zelogik/RicinoNext/Hardware/Emitter/irda_robi/IMG_20210915_181401.jpg

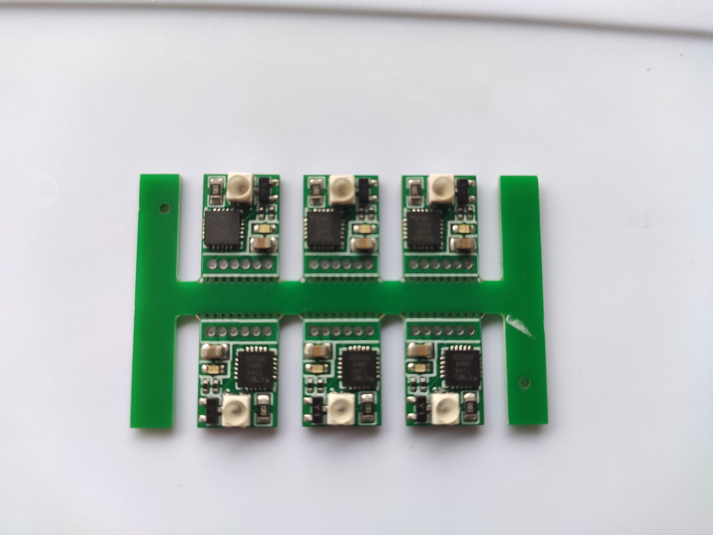
Hardware/Emitter/irda_robi/IMG_20210915_181401.jpg
