zelogik/RicinoNext/Hardware/Receiver/irda_robi_extension/IMG_20210915_181441.jpg

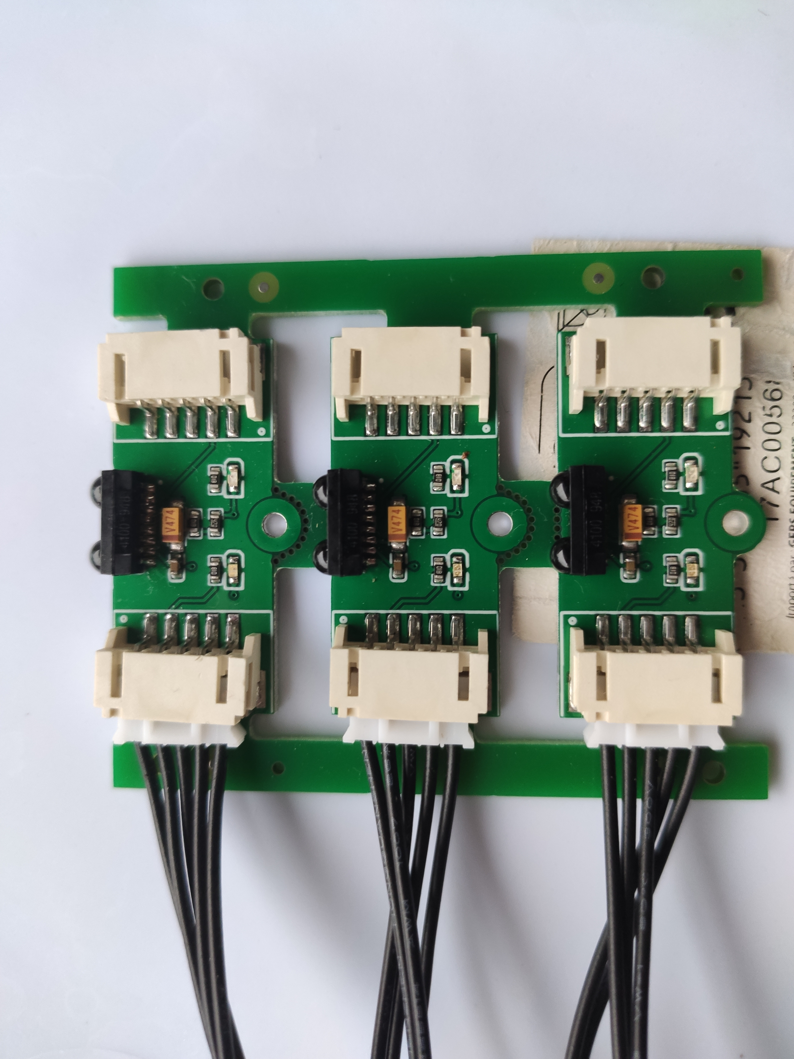
Hardware/Receiver/irda_robi_extension/IMG_20210915_181441.jpg
