zelogik/RicinoNext/Hardware/Controller/README.md

Could be an:

ESP32, ESP8266

or 

SAMD21 + ESP01/WS5x00

current dev is done on TTGO-display (ESP32), and a Seeduino Xaio (SAMD21) (without network stack).
