zelogik/RicinoNext/Software/Controller/README.md

# RicinoNext

ESP32 ie: ttGo t-display
IR led receiver
.. that all for the moment...
