zelogik/RicinoNext/Hardware/Emitter/irda_robi/PCB_x6.png

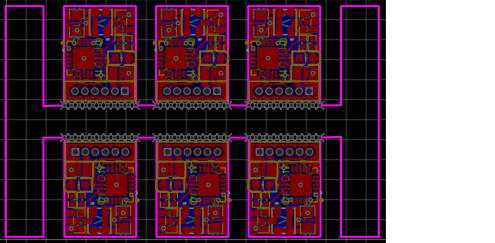
Hardware/Emitter/irda_robi/PCB_x6.png
