zelogik/RicinoNext/Hardware/Receiver/irda_robi/IMG_20210915_181500.jpg

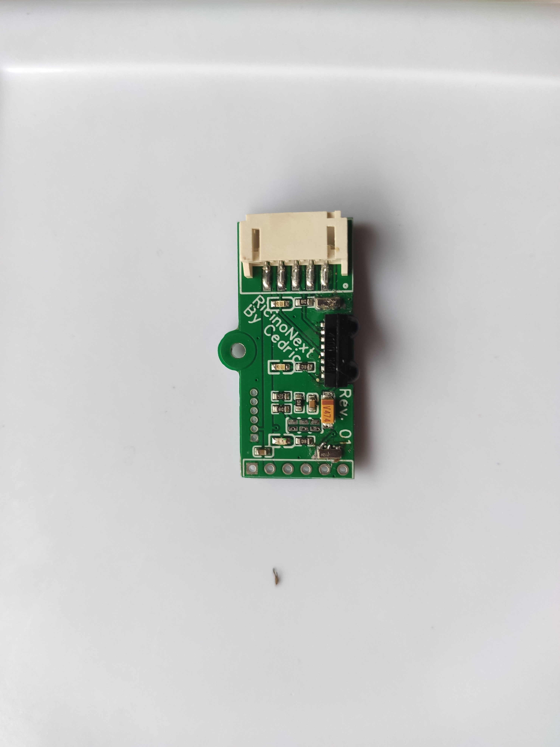
Hardware/Receiver/irda_robi/IMG_20210915_181500.jpg
