zelogik/RicinoNext/Software/Receiver/irda_robi/Decoding Scheme IRDA.png

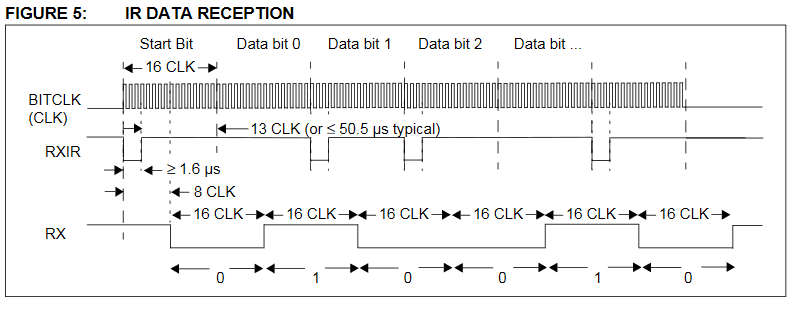
Software/Receiver/irda_robi/Decoding Scheme IRDA.png
