zelogik/RicinoNext/Hardware/Receiver/irda_robi/PCB files/BOM_PCB_IRDA_2021-09-16.csv

ID | Name | Designator | Footprint | Quantity | Manufacturer Part | Manufacturer | Supplier | Supplier Part | Price
1 | 1K | R1,R2,R3,R5,R6 | R0603 | 5 | 0603WAF1001T5E | UniOhm | LCSC | C21190 | 0.001
2 | 47 | R4 | R0603 | 1 | 0603WAF470JT5E | UniOhm | LCSC | C23182 | 0.001
3 | KT-0603R | LED1 | LED0603-R-RD | 1 | KT-0603R | KENTO | LCSC | C2286
4 | 100nF | C3,C1 | C0603 | 2 | CC0603KRX7R9BB104 | YAGEO | LCSC | C14663 | 0.003
5 | CSTNE16M0V53C000R0 | X1,X2 | OSC-SMD_3P-L3.2-W1.3-P1.20-L | 2 | CSTNE16M0V53C000R0 | muRata(村田) | LCSC | C882606 | 0.346
6 | 470nF | C2 | CAP-SMD_L3.2-W1.6-R-RD | 1 | TC211A474K035Y | Sunlord | LCSC | C128329 | 0.107
7 | SOLDERJUMPERNO | SJ4,SJ5,SJ3 | SJ_2S-NO | 3
8 | TFDU4100-TR3 | U1 | TFDU4100H | 1
9 | 19-217/GHC-YR1S2/3T | LED2 | LED0603-R-RD | 1 | 19-217/GHC-YR1S2/3T | EVERLIGHT | LCSC | C72043 | 0.025
10 | HEADER_6 | J1 | HDR-M-2.54_1X6 | 1
11 | A2001WR-S-5P_C225236 | CN2 | CONN-SMD_5P-P2.00_A2001WR-S-5P | 1 | A2001WR-S-5P | CJT(Changjiang Connectors) | LCSC | C225236 | 0.144
12 | 19-217/BHC-ZL1M2RY/3T | LED3 | LED0603-R-RD | 1 | 19-217/BHC-ZL1M2RY/3T | EVERLIGHT | LCSC | C72041 | 0.016
13 | JUMPER-2SMD-NO-NS | JP1,JP2 | SJ_2S-NO-NS | 2
14 | Female header1*6P 1.27mm | P1,P2 | HDR-6X1/1.27 | 2 | Female header2*5P 1.27mm | ReliaPro | LCSC | undefined
15 | ATMEGA16A-AUR | U7 | TQFP-44_L10.0-W10.0-P0.80-LS12.0-BL | 1 | ATMEGA16A-AUR | MICROCHIP | LCSC | C51432 | 2.372
16 | ATMEGA328P-AU | U9 | TQFP-32_L7.0-W7.0-P0.80-LS9.0-BL | 1 | ATMEGA328P-AU | MICROCHIP | LCSC | C14877 | 3.621
