zelogik/RicinoNext/Hardware/Emitter/irda_robi/Schematics/BOM_PCB_IR smd attiny_simple panelize_2021-09-15.csv

ID | Name | Designator | Footprint | Quantity | Manufacturer Part | Manufacturer | Supplier | Supplier Part | Price
1 | ATTINY24-20MU | U5,U5,U5,U5,U5,U5 | QFN-20_L4.0-W4.0-P0.50-BL-EP | 6 | ATTINY24A-MU | Microchip Tech | LCSC | C19354 | 1.344
2 | 22uF | C5,C5,C5,C5,C5,C5 | C0805 | 6 | CL21A226MAQNNNE | SAMSUNG | LCSC | C45783 | 0.032
3 | SFH_4259-Z | LED11,LED11,LED11,LED11,LED11,LED11 | SFH4250S | 6 | SFH 4259-Z | OSRAM | Mouser | 720-SFH4259-Z
4 | Female header1*6P 1.27mm | P5,P5,P5,P5,P5,P5 | HDR-6X1/1.27 | 6 | Female header2*5P 1.27mm | ReliaPro | LCSC | undefined
5 | SS8050_C2150 | Q6,Q6,Q6,Q6,Q6,Q6 | SOT-23-3_L2.9-W1.3-P1.90-LS2.4-BR | 6 | SS8050 | CJ | LCSC | C2150 | 0.021
6 | 2K | R15,R15,R15,R15,R15,R15 | R0402 | 6 | 0402WGF2001TCE | UniOhm | LCSC | C4109 | 0.001
7 | 330 | R14,R14,R14,R14,R14,R14 | R0402 | 6 | 0402WGF3300TCE | UniOhm | LCSC | C25104 | 0.001
8 | 33 | R13,R13,R13,R13,R13,R13 | R0805 | 6 | 0805W8F330JT5E | UniOhm | LCSC | C17634 | 0.002
9 | 19-217/BHC-ZL1M2RY/3T | LED10,LED10,LED10,LED10,LED10,LED10 | LED0603-R-RD | 6 | 19-217/BHC-ZL1M2RY/3T | EVERLIGHT | LCSC | C72041 | 0.016
