zelogik/RicinoNext/(threads)

Thread 1 (2022-01-22):

couple of questions

Peck07, 2022-01-22:
First of all, great project!

I am thinking of building a gate for myself, but I'm having a few issues:
"consist of 1 atmega16 for irda decoding/uart + 1 atmega328 for i2c/uart"
but I have found only one source code, for the i2c/uart part (https://github.com/zelogik/RicinoNext/blob/main/Controller/RicinoNext-receiver_i2c_robi.ino)

https://github.com/zelogik/RicinoNext/blob/main/Controller/RicinoNext-receiver_i2c_robi.ino#L188
`if( millis() - whileTimeoutTimer < whileTimeoutDelay){`
I think this should be
`if( millis() - whileTimeoutTimer > whileTimeoutDelay){`
if you only want to break the loop if the elapsed time is bigger than the timeout delay.

RicinoNext_receiver_robi.ino in the root folder:
I think it's a version of the transponder, but it's definitely not a receiver.

zelogik, 2022-01-22:
Hi,

It's been long time, I haven't touched this project... And normally this project "only" need a great UI compatible with an ESP32/8266/esp1/etc... to be usable and more user-friendly, every others aspect is already working on my setup, but now only the "serial" mode works :-D ( and need direct serial connection with a computer)

----- "consist of 1 atmega16 for irda decoding/uart + 1 atmega328 for i2c/uart"
So for the receiver code(robitronic), only one microcontroller should be enough, but I have took a dump from atmega16, the one that decode IRDA, and no source code was available. It's on my todo list to get a proper decoding IRDA source code :-D
I can send you the dump to test if you have already the hardware part. (maybe legal problem here ;-) )

----- https://github.com/zelogik/RicinoNext/blob/main/Controller/RicinoNext-receiver_i2c_robi.ino#L188
I remember to have changed that line on a previous version, to get a "working" code :-D (but tricky and not as wanted at all)
The main goal was to waiting less as possible to processing message BUT enough to be sure to get full message AND don't block the main loop/program because serial was buggy/disconnected etc...
Sure that part need some refactoring. pull request are welcome.

---- RicinoNext_receiver_robi.ino in the root folder:
It's an OLDDDD version of a transponder you're right!
The full working transponder is now attiny24 compatible (should be attiny25 or 45/85 too with minimal change), because uC shortage was a problem on jlcpcb and attiny24 is cheaper. (just remember to check the PCB layout..)

That repo (github) is not completely up-to-date from my own self-hosted repo (gitea), because nobody used it, and I was the only one to use it.

Now, If even one person want to help me to "finish" that project, I can update and give some more info to get a debug software with fonctionnal hardware :-D

IE: I have plenty of debug source code that simulate transponder, simulate "fake gate", simulate "fake IRDA decoder" etc...

Peck07, 2022-01-22:
Thanks for the quick answer :)

"Serial" mode is not a problem for me at the moment, I understand this is not a 100% finished product.

"Sure that part need some refactoring. pull request are welcome."
I'm willing to help, but until I can't test something, I am a bit hesistant :)

Right now I don't have the hardware.
The issue is, that the ATMEGA328P is 18usd (one) at jlcpcb, ATMEGA16A is out of stock, so I was thinking maybe it would be cheaper to do the decoding with an ESP32 as well :) at least I've worked with it, and if I could separate the decoding on one core, the other could do the WiFi/i2c, or whatever. (I was rather thinking to write a lighweight android program for the UI)

So maybe I'll order 5 receiver PCBs, and hook it up with something, like the mentioned ESP32.

zelogik, 2022-01-22:
piouuufff price of uC have skyrocketted !!! but jlcpcb does double side smt assembling and soldering now?
Because i have used to made a simple face SMD assembly and soldered by hand the uC (very very simple, and less than 1min/unit, with simple soldering iron and paste)
And I have received ATMEGA328P**B** instead of ATMEGA328P , normally not 100% pin compatible with ATMEGA328P, but it's just GND and something not revelant for our use. Just little more difficult to integrate at first to arduino IDE.

It's the same for ATMEGA16A and TFDU4100 (EOL...), have been ordered on aliexpress and soldered by hand :-D
So: ATMEGA16A, TFDU4100, ATMEGA328P**B**, and quartz was soldered by hand and purchased on aliexpress.

For the android program... I don't think it's a really good option, remove the single use of a browser and so compatible with every screen (Chrome,Safari,Firefox,...)
For the decoding of IRDA with the esp32, don't think it's ok, seem like we need hardware compatible uC with IRDA, because time is in uS and not mS like simple IR, and decoding in software will be tricky (but not impossible with lot of interrupt) :-D

Ie: I'm from France, and I maybe have some hardware available, and some debug code available to test without ALL hardware. ie: first code draft/test/debug was with a simple ESP32 + arduino nano, and after with an Samd21 + arduino pro micro.
ie: the emitter + receiver work at 100% but i don't have source code for the receiver part.

Give me time to check, and depend of your "CV" and motivation I can send you some real board! :-D

Peck07, 2022-01-23:
Thanks for the offer, I'm looking for a cheap lap timer, but not for free :)
Also, maybe it will be never required, but it would be better, if there's a possibility to rebuild it anytime.

jlcpcb: they do singe side still, I just tried the uC side.

ESP32 IrDa decoding: there are a few libraries available, I'll try it if I have a chance, and receivers.

Android program: I just thought it's easier to implement it that way than solve everything with html/javascript, etc. also I think we will meet the limits of ESP32 pretty soon :)

To get the project going, I think it would be good to:
- upload the latest code
- upload any debug code for testing without HW
- list the existing issues, improvement ideas (like what do you expect from the HTML view)

Also, I can start something with ESP32 and a webserver, to see how it works, no other HW required :)
And I know you want it PC free, but integration with zRound would be pretty easy:
https://www.zround.com/wiki/doku.php/lapcounters:protocols:open

bladesling, 2022-01-23:
I don't mean to intrude here. I develop the Next level Timing software. I would also consider adding support for the hardware if there was some sort of serial comms. I might also consider web socket. Although my software doesn't have support for multiple gates. I'm not sure what an interface for that would look like. The zround protocol doesn't look bad. However, there is no support for gates in that protocol.

I started watching this project in the event you went that direction. I like the idea of a build it yourself timing system. I've been considering how something like this could be done for some time. It is a very impressive endeavor. 👏

I'm currently working on my first Arduino project. Once I get that done I'll review this project in more detail. It might be a bit- I'm a noob at this Arduino stuff. But this looks like fun.

Looking at the architecture, it looks like it wouldn't be too hard to build new a new type of "serial live console" to add support for other timing softwares. Kinda like "replace" that system with a different one. So from that perspective it is a nice architecture. I also like the use of the ESP32 wifi.

Peck07, 2022-01-23:
Actually that's great news :) I've already checked Next level Timing yesterday, but didn't find a protocol description, so I went forward (zround).
zround/Next level Timing doesn't support multiple gates: that's true, but even with one gate, the integration would be pretty useful.

zelogik, 2022-01-23:
Nice to see some people interested :-D

@Peck07: an another argument again Android app or specific OS app, don't know if the app will work in the next 3 or 4 years without update it on next version of android/iOS/etc.., and alone I clearly don't have time for it ;-D javascript,json "should" be always compatible in 10 years in any futur browser.
For the update of the code, to be honest, my time is precious now..., I have updated  the minimum on that public repo only to see if somebody is interested, as you and bladesling are interested, I will prioritize that project a little more now, give me some time to update this repo.(and post hardware-free debug code :-D)

@bladesling: I have already seen your project. The downside for me (and it's the same as zround! And ALL lap-counting that work), i really really don't like closed-source app (even if your have a linux working version) :-p
The goal of my first working draft was: ESP8266 (change by ESP32 if you want) was to propose a websocket (json) and/or webserver (html+java) so was capable to be connected by a simple browser AND/OR in the same time by an QT app (to get correct Log/HIstory) i have quickly done, and every "screen" was in sync. So the QT app could be changed by any specific APP compatible with websocket protocol.

To explain this project, it's not the first version of ricino...
- I have forked it from cdemetriadis/RiCino-Lap-Counter, but without any insult to cdemetriadis, the code was very very bad quality (from my POV as self-learned coder), and I have changed around 95% of original code, it's why I haven't merged.
But that code, was compatible with zround and ricino protocol, but only accept a sort of CoreIR, NEC RC5 IR code, (with many many don't detected lap when hardware was installed and tested on my mini-z circuit)
- The second code is a mock-up to test json/html/java with an ESP8266 ( webserver side) and atmega328 (lap counter side), zelogik/ricino, test the best protocol available (IRDA,RF,IR,RFID,etc..) and easy to make an hardware DIY version, start to make some infrastructure test. Because as both of you have seen is that zround protocol don't support multiples gates and the interface is ... hum... year 2000, and don't work on linux (and a VM for that...)

- And the third one, that repo, every block is "theorically" ready or already have been wrote by me (even json/java side), not optimized at all but works! Just need some time to get all working together in a nice side.
This code is "theorically" easy to adapt as plugin (zround connection/ websocket connection)
And I prefer the backend side, the frontend HTML/CSS is not really for me :-D

The only side i haven't yet found on my architecture choice (don't use third party software except simple browser) is a correct History/Log of best lap etc.., not a 8Bit save in the EEPROM like the '80/'90 arcade game.

IE: yes a zround compatible is not hard at all, as I have already done it on previous version. But that not wanted for me as zround is neither open-source, not working on Linux. and don't have good protocol (multiple gate, CRC, etc...)

bladesling, 2022-01-23:
@Peck07 sorry about the lack of documentation about the supported protocols. At one point I was asked to not share some of the details about the protocols and so I opted not to share any of them. I didn't want to upset the hardware makers. I did however not sign the NDA that MyLaps wanted for their protocol, hence the lack of support.

@zelogik I understand about the desire for an open source solution. Have you checked out Flipside? Again, no multi gate 😔.
http://www.flipsideracing.org/projects/fslapcounter/

A self contained hardware solution is a great idea. I respect your vision. A bunch of people ask me for software that can run on a raspberry pi. But I'm unsure if you would consider that self contained since an os would be required.

As for the comments on html/css and frontend in general- I think that is not super uncommon to not be interested in the entire spectrum of application development. There are only a handful of software engineers who are interested in working on an RC project. I suspect that applies to designers too. That leaves it up to people like us who are programmers to build the UI, design, frontend, backend, hardware integration, hardware, etc... which leads to a mediocre experience. I spend absurd amounts of time on UI and design and I know it could be so much better if real UI designers were involved.

This is why I try to support several protocols. It is likely I will adopt the zround protocol. However I usually do not add support for protocols I don't have the hardware to test it with. It isn't a good experience. Suppose I could make some hardware. But then I have to install zround on windows to make sure it works... 😩  I could make my own protocol faster. With something modern like JSON... lol.

Peck07, 2022-01-24:
@zelogik I'm not in a hurry, take your time :)
Android: I don't want to argue more on this issue, as it seems to be a no go, but I thought also about some QT app + websockets for example, so the protocol under the hood could be exactly the same as if you go with html/css/javascript :)

@bladesling no need to apologize, I can totally understand why I can't find documentation about the protocols.

"not be interested in the entire spectrum of application development." fully agree, also I don't want to reinvent the wheel, if it's not necessary :)

I wouldn't say you you should support zround protocol, just make some own protocol available, _like_ zround did.
It's probably easier for you (although you'll need to have some documentation :) ), it's easier to fit in your software, test, etc, and I think it's totally fine for any 3rd party (like this project), that it should adapt your protocol, if it wants to be compatible with Next level Timing software. The key here is to have a documented protocol for easy adaptation.

zelogik, 2022-01-24:
@bladesling Yes FlipSideRacing was useful to get some informations on different protocol etc...But haven't been updated since almost 10years...And I doesn't know RealBasic programmation.
And i thought about a raspberry Pi too, (plenty available on my shelf of course ;-)), but the same as an Android app apply here, we need library compatibility, update software etc...
LOOOLL on your comment on UI design, yes it's sooooo time consuming. And for that version of RicinoNext I prefer to get a 100% working serial version before merging my previous work on json/Css/html on the ESP.

@Peck07 Exactly, If i find somewhere time to got a working public version, with JSON and HTML/CSS server almost working, nothing forbid to add app after that, it's open-source after all ;)

The idea was to get a self contained hardware without any OS for very simple LapCounter with a simple LCD display or dot matrix for example, BUT with option of serial OR JSON communication protocol to get Browser/apps connections possible to get more advanced control (History/graph/bigger Screen/etc...) :)

For the moment what works:
- Hardware: 100% for a minimal working version (all PCB should works)
 Homemade robitronic works, (emitter and receiver)
 Connection between Gates(controller) and Master work wonderfully (just the CRC to be implemented)
 Add addon card (Sound/buzzer, Light, etc...)

- Software: 50%
 As already said, a 'live serial console' works, so the lap counter works :), and I think my code is not too ugly to be future proof and finish.
 I have already tested and made a JSON and HTML/CSS working on a ESP32, just need to rewrite in a nicer way ( to be compatible with samd21+ESP01 and ESP32 ) :-), but javascript is not a pleasure for me :-p

Peck07, 2022-01-24:
Oh, OK, then I don't need to start everything from scratch :) (already fired up a webserver on ESP32, and a pretty basic html + javascript, it's still static/hardcoded values, but it fills the data from JSON )
I don't know about the compatiblity.

zelogik, 2022-01-24:
Look at:
https://github.com/zelogik/Ricino

That public version should work! (the JSON,CSS,HTML)

zelogik, 2022-01-24:
From what I have seen, we need a JSON for lap time, best, mean etc... (more or less already done), ESP -> client
That code could send ALL player at a time or for efficiency only player that have changed rank.

BUT we need a way to change number player/number LAP/number Checkpoint/addon/etc.. from client (web/app) to ESP (and that ESP will push to all others clients connected for sync screen).

Number of LAP and sync to all screen works on the zelogik/ricino project, but the dynamic line for number of player (and why not put name on each player) is a problem...

Peck07, 2022-01-25:
Thanks, but that's almost ready :)
Took some time, dependencies, and some minor changes to get it to work on ESP32, but it's working now.
So I've started to generate the lines instead of the fixed 4, it's working pretty well. Also added a name column :) (only at the frontend side)

zelogik, 2022-01-25:
"I'm not a javascript guru, but the code is well-formed, most of the times easily understandable.", my javascript code, who is well-formed ?

This evening, I will get some time to dive into my code, haven't read it since 6month... Need to re-understand it. But your post have motivated to update that software ;)

zelogik, 2022-01-25:
The webui code in the ricino repo need to be updated( and uploaded) to the ricinoNext repo, but before that I/we need to set a proper JSON structure.
You can make a pull request on this repo.

Thinking about a JSON structure like this: for server -> client

- conf:   number lap/player/gate, name player, etc... All parameters that modify configuration, parameters etc... (UI need to be disabled when state = race), server will not accept any parameters when state = race.
- state: race/end/reset ("reset" zeroing player stats, "race" start live counter with time in ms, and "stop" stop everything)
- live: send only info on the last player rank/lap/checkpoint

client -> server:
- conf: number lap/player.
- ?state? : race/end/reset (maybe only allow the UI who as initialized the start to stop and reset ?)

What do you think?

Closed 2022-02-05.

Thread 2 (2022-01-25):

Define a clear JSON api

zelogik, 2022-01-25:
First draft:

```
{
    "config": {
        "lap": 10,
        "player": 4,
        "gate": 3
    },
    "state": "stop",
    "live": {
        "rank": 1,
        "best": 0,
        "current": 0,
        "last": 0
    }
}
```

Peck07, 2022-01-25:
sounds good, two comments:
- I wouldn't set the player number (if not necessary), should be dynamic, coming from the transponder IDs.
- the "live" part could be exactly the same as in the working webui code at least for starters.

zelogik, 2022-01-26:
- thinking about sending only the "rank"/"order" of the transponder ID of course (as the controller/server already have a fast and working algorithm) and it could help at frontend side (or maybe not...).
But we need to find a clean way to "dynamically" set a transponder ID with a name/number player from the frontend and sync with all others frontend/browser connected to it....(the server don't have to know/save the name/number player, just receive and sync to all clients.)

maybe add a client JSON request like { state: waiting }, asking for server to send the first transponder ID received and stop.

- yes the "live" part seem a good start as I have already passed so much time, to get it working :-D

IE: Sorry to making a big spring cleaning, and reorder/rename folder, but even me can't remember what I have done ;-D

zelogik, 2022-01-26:
Edit:

Example ot the message sent to the "serial live console":
        Serial.print(F(" |ID: "));
        Serial.print(F(" |laps: "));
        Serial.print(F(" |Time: "));
        Serial.print(F(" |last: "));
        Serial.print(F(" |best: "));
        Serial.print(F(" |mean: "));
        Serial.print(F(" |1: "));
        Serial.print(millisToMSMs(idData[j].lastCheckPoint[1]));
        Serial.print(F(" |2: "));
        Serial.print(millisToMSMs(idData[j].lastCheckPoint[2]));
        Serial.print(F(" |3: "));
        Serial.print(millisToMSMs(idData[j].lastCheckPoint[0]));

That mean that server DOESN'T know anything about player number/name only the rank/position/order (that information only missing if we want to store the 8 best lap on the EEPROM with name :-)... or maybe to display name in the serial console/TFT too)

Peck07, 2022-01-26:
"as the controller/server already have a fast and working algorithm) and it could help at frontend side (or maybe not...)."
yes, I would leave it to the server, and keep the frontend lightweight.

player name/number:  my idea: don't overcomplicate it, if there's nothing set, the transponder ID will be the name, or some random string :)
Of course it should be changeable from client (simple JSON with transponder id, player name)

zelogik, 2022-01-26:
I don't want to overcomplicate it, just find a solution to sync client name to all other client connected to the server. In a nice and clean way.
But we can go without that feature for the moment ;)
Same problem I have faced before... what the better way to "refresh" current time of each player lap  (check point portion) and current total race time:
- On the client side (with possible drift between displayed client time and the real(and official) server time)
- On the server side, but with the problem to send JSON message every 100-200ms minimum to refresh all times on all clients, and so, don't have a "non-sluggish" UI.

Peck07, 2022-01-26:
The way I proposed, the sync will be automatic between the clients, as the server "stores" the names, if you change a name from one client, after a while, it will be synced between clients (as the information comes from the server eventually).

race time: I have seen the Stopwatch class :) I think it's a great idea to run some timer on the client side, but sync/update sometimes from server data. (I think this was the original idea, but I don't think it's working correctly right now)

zelogik, 2022-01-27:
The player name is not a top priority at all of course, but a nice to have feature we need (and implement)

My top priority is to merge my last version of: RicinoNext-receiver_i2c_robi.ino + RicinoNext-master-sortAlgo.ino + RicinoNext.ino

- RicinoNext-receiver_i2c_robi.ino -> have good communication with receiver and i2c, must be fully fonctionnal.
- RicinoNext-master-sortAlgo.ino -> very good sort algo (from my POV), good struct/class for player data. (post-processing data), it's the most important code after all.
- RicinoNext.ino -> The one that have a almost working WEBUI / JSON communication. (and need to be optimized in many way).

But haven't touched that code since more than 6months, and I have forget many things, so much version to debug each part.

So I will merge RicinoNext-master-sortAlgo.ino with RicinoNext.ino, to get a debug version and hardware-free version.

zelogik, 2022-01-28:
First "official" JSON api draft:

**Server -> Client**

{
    "config": {
        "lap_total": 10,
        "players_number": 4,
        "gate_number": 3,
        "light_state": 0,
        "light_brightness": 0,
        "players_conf": [ {"id", "name", "color"}, {"id", "name", "color"},  {"id", "name", "color"},  {"id", "name", "color"}]
    },
    "race": {
        "state": "STOP",
        "lap": "0",
        "time": "0"
    },
    "live": {
        "id": "XXXX",
        "rank": 1,
        "lap": 0,
        0: [      // make an array for each gate?
        "last": 0,
        "best": 0,
        "mean": 0
        ],
        1: [
        "last": 0,
        "best": 0,
        "mean": 0
        ],
        2: [
        "last": 0,
        "best": 0,
        "mean": 0,
        ]
    }
}

**Client -> Server**

{
    "config": {
        "set_laps": 10, // 1 - ? unlimited ?
        "set_number_player": 4, // 1 - ? 32 max ?
        "set_number_gate": 3, // 1…?8 max?
        "toggle_light": 0, // 0-1
        "set_brightness_light": 0, // 0-255
    },
    "state": "STOP", // START, ?CONNECT?
    "set_player_name": ["ID", "name", "color"] // set player name one by one? Or all at a time…
}

zelogik, 2022-02-01:
@Peck07 : You can test the first beta for a working hardware-less version.
it's in the devel branch -> software/controller/RicinoNext-controller.ino  (yes I know... need to do more name cleaning :-D)

Some details that don't work yet:
- "race"->"message", should be ok this evening/next release
- rework on the JSON sent (ie: "conf"), to have an unique JSON function for a broadcast message or unique client a connection. ( just need to merge from my side)
- "live" and "race" JSON message works, but the .js frontend need update (have you already done some work on the frontend?)

The only way tested to start/stop a race is with the serial command (old function with JSON should work but not tested, and API will be changed on the client->server message with the new API)
for the moment I have only tested JSON server->client with a simple python script.

Peck07, 2022-02-03:
Thanks, I will check it!
Regarding the JSON: I would keep the same JSON format (where possible), so no difference in the server->client, client->server JSON, no "set_".

zelogik, 2022-02-03:
Have updated the RicinoNext-controller.ino.

The confToJSON work well! But got some troubles getting JSONtoConf working (need to read the "Mastering arduinoJSON" more :-D). The old code works but was not optimized and the technique was not recommended because not efficient from the arduinoJson author himself.

Peck07, 2022-02-03:
Having trouble with Button2,and  ESPAsync_WiFiManager :)

zelogik, 2022-02-03:
Will remove button2, as it's specific for TT-Go display.

What the trouble with ESPAsync_WiFiManager?

Peck07, 2022-02-03:
ESPAsync_WiFiManager: that's a new library/dependency for me, but managed to add (I am using platformio)
Button2: I put that behind compiler switch :)

have you already done some work on the frontend? Yes! (on the ricino/webui, but I will try to merge into this project my changes)

zelogik, 2022-02-03:
Yes, now that the JSON algo server<->client is almost working ( but not bug-free) i will merge devel repo to master.
The ricino/webui is a good start but every JSON message have changed, but good New is that the JSON API is not far from being finalized.

Peck07, 2022-02-03:
Ok, the frontend wasn't even working as before, so I've put back some functions, and added the base of the line generation code:
https://github.com/Peck07/RicinoNext/commit/5f62dd5070626b09d14e55368230831c029d3992

zelogik, 2022-02-03:
My bad for the JSON API change :-/ but it's was necessary. As I have already said, shouldn't be changed as much now :-D , the last API worked but has so many problems/tricks/bug.

And yes I have seen that the onEvent interrupt was totally broken on the backend side... it's in my "urgent" todo list before removing many already seen bug.

the last ino was ESP32 compatible but not TT-GO Display compatible (esp32 too), you have added the esp8266 compatibility , nice, need to check available memory later on that architecture :-D.
I will manually push the "https://github.com/Peck07/RicinoNext/commit/516c155c8cd6d67f6270f8c9cfd5e45329a5e021" commit with the new cleaned ino, shouldn't take long.

I have quickly read the frontend job you made! It's wonderful :-D, your javascript level is better than me for sure :-D
don't hesitate to issue a pull request on the main branch. (folder architecture have changed too... sorry but imo easier to understand now)

Peck07, 2022-02-04:
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

1 |ID: 4660 |laps: 5 |Time: 00:29.539 |last: 00:06.975 |best: 00:06.975 |mean: 00:05.907 |1: 00:02.325 |2: 00:01.744 |3: 00:02.906
2 |ID: 4919 |laps: 5 |Time: 00:30.127 |last: 00:08.725 |best: 00:06.289 |mean: 00:06.025 |1: 00:02.325 |2: 00:02.906 |3: 00:03.494
3 |ID: 1638 |laps: 4 |Time: 00:23.727 |last: 00:07.556 |best: 00:07.556 |mean: 00:05.931 |1: 00:03.487 |2: 00:02.325 |3: 00:02.907
4 |ID: 9320 |laps: 4 |Time: 00:24.308 |last: 00:08.137 |best: 00:08.033 |mean: 00:06.077 |1: 00:03.487 |2: 00:03.494 |3: 00:03.488

bladesling, 2022-02-05:
Any chance for more raw and live data for integration purposes? Basically push events to serial comms as they happen. They are not amazing for clients connecting mid stream, but a combination of what you are doing and events could help improve the "live" aspect of the frontend.

1. Fetch current state for frontend display
2. Listen to new events on the frontend
3. Compute frontend display using events. Doesn't even have to be all the data.

Example of some live events:

Transponder Passes Gate
```json
{
  "type": "transponder_passed_gate",
  "gate": 1,
  "transponder": 4660,
  "time": 223335
}
```

Race Starts
```json
{
  "type": "race_started",
  "time": 0
}
```

Race Ends
```json
{
  "type": "race_completed",
  "time": 12000
}
```

zelogik, 2022-02-05:
@Peck07 : amazing :-D, waiting your push request, as I haven't do much change on the frontend.

@bladesling : don't know if I have understand all your need...

1. Fetch current state for frontend display
   - Every 1sec in waiting state (or 500ms when race running if I remember), the race status is broadcast sent (look at the wiki).  : {race:{}}
   - what different with the current {race:{}}, yes, there is a 1 or 2sec of "unknown" state for the client.

2. Listen to new events on the frontend
   - At each new websocket connection, the server send "frontend" status (player number/gate number/name/etc...) : {conf:{}}
   - each client could send a {conf:{}}  (except wait race running). Only a stop command could be send at race (maybe need to forbidden if browser fingerprint is not who triggered the start command)

3. Compute frontend display using events. Doesn't even have to be all the data.
   - live status is sent at each triggered gates. {live:{}}, and only one transponder is sent, not what you look for?
   - at each modification from one UI, the new {conf:{}} is broadcasted.

Maybe you asking for "serial" interface ? for the moment void WriteSerialLive(..) output and ReadSerial() is "only" to try/debug.
I need to implement a SAMD21 <-> esp01 connection with serial (or i2c), and data will be the same as the JSON sent/receive from websocket. So remove the esp01, and add a computer instead, should work. But it's not in my priority list for the moment, sorry ;-)

ie: look on the draft wiki :-D

Peck07, 2022-02-05:
The original code had the conversion, just had to refactor it a little bit, but I didn't check the performance :) shouldn't be a problem, also the code is quite flexible, removing the conversion is pretty easy, so I'd say let's keep it that way right now, and change it when we feel it's necessary :)

zelogik, 2022-02-05:
Yes it's just optimization... timeToChar(..) use many / and % the worst thing for uC so could be less than 80uSec. (bitwise to our help, but losing some precision)
And as i start to thinking about implementing dynamic allocation of the JSON message size. length of each message will be important (millis(ie: 16.5min = 999999us) vs 00:00.000'\0'), so 6 vs 10 bytes... but yes it's not the priority ;-)

bladesling, 2022-02-05:
Apologies- I didn't understand the frequency of the live updates. Carry on lol.

zelogik, 2022-02-05:
@bladesling : live update is sent every time a gate is triggered :-D, only one player at a time

Peck07, 2022-02-05:
Actually I've put back the "Current" column, so a timer is running on the frontend side as well, pretty accurate, and it's more "live"

zelogik, 2022-02-05:
> Actually I've put back the "Current" column, so a timer is running on the frontend side as well, pretty accurate, and it's more "live"
:+1:

zelogik, 2022-02-06:
#7 , wiki draft, ...

Closed 2022-02-06.

Thread 8 (2022-02-06):

What to do with reset, light, read_ID (trig input)

zelogik, 2022-02-06:
- Reset:
Should we reset every lines OR ask for new values from server (resetted too)
Or just one line at a time (your todo question)

- Light:(anything else that can be triggered)
client send a conf:light as the server is value == 1, put the that value to 0, broacast new conf, and set light or whatever ?

- read_ID:
put the backend in receiver mode  only during x time (not put in race mode) and echoing in race:message|whatever and|or regex it in frontend.

my question is: should we create a new function reading directly in uiConfig after receptionning JSON...  (or use struct as class and make a simple uiConfig.loop() and call it at each loop).

Peck07, 2022-02-06:
I would say in general, that server should store these values as well, and broadcast it, so every client knows the actual value.
And I liked when I could control the LED on the ESP32 :)

Reset: I don't know which todo you are referring to, I had trouble with wherre to put a "reset", which clears the lines (between races for instance), but now we have a reset button, which is totally fine.

zelogik, 2022-02-06:
Finally, for the light/led, the conf is just the state of the light so easy.

But the reset... what i though was: start -> fill every var/int/char/table/array possible -> stop... let everything, to view/check, compare. and here two options:
- repush start and let the magic operate (reset clear , on server and so on for client  during the "warm-up" time.
- push reset and so clean evrything, and after that push start

so now that i write idea, it's clear: when conf:reset = 1, client->server, that mean that client requesting reset stat/race from server (should be disabled during race.) and so all client reset frontend too.
But this event should occur only one time, else clent will everytime be resetted...

zelogik, 2022-02-08:
Reset bug: c197434239cf1005e05e09476e167f9184a4d048 and 34e4f622c3a295fe149ac61bfd0b413969654e38

Light implementation: a3547655eb400021ab2493dc9585a6d664300141
todo: define led pinout and what to do with the led class... (light speed etc...)

We can close it!

Closed 2022-02-08.

Thread 9 (2022-02-06):

OTA is mandatory!

zelogik, 2022-02-06:
First implementation of OTA on esp32

- only firmware w-ork and have been tested.
- filesystem need some test and more implementation

http://.../update
Haven't use AsyncElegantOTA because the obfuscation code is a no way !

idea: get two page (or tab). on for conf+update, the other for live+race data

zelogik, 2022-02-06:
@Peck07 : I have added  webOTA for the firmware, need to implement simple OTA to upload with arduino IDE or platformIO without use web upload

Other change:  4967e89 , don't need to upload on the SPIFFS of the esp32, we can develop directly on localhost for html/css/javascript :-D
In a console: python debug_frontend.py
on browser: http://localhost:8080

And now: http://ricinoNext.local if you want to connect directly on the ESP32 (and load webui directly from ESP32)

Nice feature for the dev no ? :-D

Peck07, 2022-02-06:
I have used a simple trick developing on localhost :)
} else {
         console.log("window.location.href is not an http URL");
         //document.getElementById('potVal').innerHTML = "<font color=\"red\">!! NO HOST !!</font>";
+        ourURL = "http://192.168.1.105/";
+        chop = 7;
     }

of course the IP is hardcoded, so I didn't commit it, but my ESP32 gets the same IP address everytime, so it did a trick for me.

zelogik, 2022-02-06:
Yes I was doing that long time ago on my first ricino version, but hardcoded IP is not a very good thing :-D, even more than we are two to develop here now.

Now the index.html load everything (css/java/script) on the computer and receive the JSON from esp32. And when we are happy we can push on the esp32 spiffs

zelogik, 2022-02-08:
see: e7b4f11afb4af44b33dc50ea51250845085e3af5  for the firmware
For the SPIFFS, dev is done on localhost.

Can we close ? I say YES for the moment, full OTA is not priority, as we can dev without serial connection (as I do).

Closed 2022-02-08.

Thread 12 (2022-02-07):

How to handle stopStopWatches(), frontend vs backend

zelogik, 2022-02-07:
```
function stopStopWatches()
{
    **// todo: need a trigger message from the server?**
    Object.keys(stopwatches).forEach(function(key)
    {
        stopwatches[key].stop();
    });
    stopwatch.stop();
}
```
@Peck07
two solutions:
1. We can add a bool or enum (ala raceStateChar[]), on the ID_data or UI_Config, with "registered", "racing", "finished",... more or less, or just true/false with true when finished :-D
  - con: add more info (size) on the live json message
  - con: during race/live need to check {conf:} to view if player have finished.
  - pro: One more check done on the server side. and keep light frontend
  - pro: that all ?

2. Or on the frontend side. each frontend test if lap >= total_laps, and so triggering stopStopWatches() ...
  - con: each frontend take care about their own "live" current time
  - pro: seam easy to implement and need less JSON message. (simple test lap number? between last {live} and config_global.laps

ie: And i don't know if I have already said, but you have done very good improvement on the frontend scripts.js :+1:

zelogik, 2022-02-07:
stopWatch continu to run after finished, haven.t looked further. Childs to occupying 🤪

Peck07, 2022-02-07:
I'm on main branch, but checked your mentioned commit.
`if (obj.live.lap == config_global.conf.laps) {
            console.log(obj.live.lap);            stopStopWatches(id1);
        }`
There you should just call
  `stopwatches[id1 + "_current"].stop();`
and don't need to modify stopStopWaches :) it's for stopping all the stopwatches (like when you reset the race)

The only issue I see, that sometimes some players don't reach the final lap (could be a backend issue, or message order)

zelogik, 2022-02-07:
Or just uncomment the "STOP" condition i have commented on the same commit. Will test later

zelogik, 2022-02-07:
> "do you think it's easy to fill player/color everything when we push the start button, without waiting for the live updating it (warm-up Time) (or let the backend send it one time...)"
> yes, should be easy, but I like it this way too (players appear line by line) :)

Finally yes, it's nice like this... but ...
How we set player name/color/id, I think it's time to add a tab

One tab, containing only STOP, TOTAL time, LAP/TOTALLAP, and player current statistic (ala nextleveltiming :-p)
The second with every "conf" thing (lap/number player/number gate/checkbox etc..), and including name/color/id setting. and start button, when pushing start button, automatic switching to the "live" tab.

Need to  make a draft/template/?Or  have you understand me ? What do you have in mind for the "player name setting".
As it's in plain javascript (or jquery), we should keep a KISS interface :-D
For the data logger, history, a more complicated client (qt/gtk/android/c#) , could be done, storing every thing. ( in a long long future, very low priority on my side)

> "ie: And i don't know if I have already said, but you have done very good improvement on the frontend scripts.js ￼"
> Thanks! But believe me, I didn't touch javascript for years :)
Always better than me, the scripts.js was my first line of javascript ever....

Peck07, 2022-02-07:
Speaking about KISS :) I won't introduce another tab if not necessary, of course if we want to change every single config... that's another story. But we can extend the left panel with additional configuration, and hide the panel if a Race is running (and show the Lap/Totallap and other important stuff somewhere else).

For player names/color, I think I have something in my mind, just give me a few days :)

zelogik, 2022-02-07:
:+1:  for the left panel hiding/showing (every single config is just maximum 20-30 checkbox, slider, and maybe radiobox, should be ok in the height)
I don't like the tab interface too, but was sooooo easier for me to implement :-D
And for the names/color, you have complete freedom.
Keep your time, I need to implement on the backend the dynamic player too, I think I will simply create/populate a 16 or 24 max player struct, and use only the 0<->NUMBER_PLAYER. So we can avoid desallocation/allocation/free/malloc, as each uC have limited memory so just need to test the max for each uC...

Closed 2022-02-08.

Thread 14 (2022-02-08):

Backend don't reset every data after first run.

zelogik, 2022-02-08:
todo:
- Implement and debug a correct reset backend <-> frontend.
- Check every variables to reset properly after each run on backend.

Edit: Backend don't even send every player....

zelogik, 2022-02-08:
c197434239cf1005e05e09476e167f9184a4d048 and 34e4f622c3a295fe149ac61bfd0b413969654e38

Should be ok, need more test

Peck07, 2022-02-09:
Just tested it, seems to be good.

"todo": I don't think we should disable the other clients, I mean other client could stop the race as well.
other than that: the lap slider is already disabled when a race is runninng :) but the new players/gates are not disabled.

"Ready for the first "almost" fully working RicinoNext ? :-D" Almost :) I've ordered the PCB for receiver/controller as well + IrDa, and uC, maybe I'm still missing something... but most of the parts are on their way to me.

zelogik, 2022-02-09:
I don't know for the "secure" side, maybe allow others client only if the client who have "pushed" start is disconnect.. but neverming it's not really a must have feature for the moment
Yes need to factorizing slider/lap code on the JS side. each if condition is "meh"...as the {conf} should always be full, maybe change to array... need to be defined.. later ;-D

Strange because sometimes I don't have zero value in last/best row but the value from the last race...

Have you added quartz ? or more precisely 16mhz resonator

Just have checked my ali basket.
- Cable for gates connection: (reverse 5poles)
https://fr.aliexpress.com/item/1005002164519210.html?gatewayAdapt=glo2fra&spm=a2g0o.9042311.0.0.27426c37wq4USf
- IR led for transmitter ( on you could add robi clone), but 1 transmitter cost me around 3 or 4 euro (maybe less, don't remember)
https://fr.aliexpress.com/item/33029593345.html?gatewayAdapt=glo2fra&spm=a2g0o.9042311.0.0.27426c37sGrFI7
- resonator murata 16mhz (should be 2 for each receiver atmega16 + 328p/pb)
https://fr.aliexpress.com/item/32366504212.html?gatewayAdapt=glo2fra&spm=a2g0o.9042311.0.0.27426c37sGrFI7
- IrDa transceiver (yes we can transmit data too... maybe a future future plan to reprogramme emitter ID code )
https://fr.aliexpress.com/item/33050427742.html?gatewayAdapt=glo2fra&spm=a2g0o.9042311.0.0.27426c37sGrFI7

And the last
- JTAG 1.27 ( 5 or 6 pole don't remember), really useful, bug was mainly useful to decode, upload (many many time) on transmitter side, normally just a one time for each uC on each receiver. So depend if you want to struggle with it:
https://fr.aliexpress.com/item/1005001308050117.html?gatewayAdapt=glo2fra&spm=a2g0o.9042311.0.0.27426c37wq4USf
ie: expensive for the product but haven't time to purchase pogo 1.27 pin/design/3d print here :-D

Sorry link are in french ;-D
And impressive ... I have quickly checked the price... everything have increased between 15 to 40%   8-(

Peck07, 2022-02-10:
Thanks!
I was missing the resonator - IR LED still.
Also I will probably direct solder the receivers, as jlcpcb didn't have the connectors :(

"reprogramme emitter ID code" that would be awesome! but the emitter has a simple infra LED, right (so it can't receive)?

Wiki:
- It would be good even to mention these resources / jlcpcb.
- programming instructions :D (like how to compile in arduino / it doesn't support the attiny by default)
- pinout order

zelogik, 2022-02-10:
Strange connectors was available and already soldered from jlcpcb... maybe I have changed at order time, don't remember

Peck07, 2022-02-10:
They were just short on supply I guess. I think I've got connectors on the Controller, but not on the Receivers :)

zelogik, 2022-02-10:
Have lost many hair with that emitter code, but was so fun!!!

zelogik, 2022-02-11:
You already have hardware? receiver/emitter at home ? :-D

ie: I reading old code on the I2C, and will merge I2C integration soon.

Peck07, 2022-02-11:
Only the emitter, but stilld don't have the IR LEDs.

zelogik, 2022-02-16:
duplicate #28

zelogik, 2022-02-16:
#29 Fix

Closed 2022-02-16.

Thread 17 (2022-02-10):

Emitter code doesn't compile

Peck07, 2022-02-10:
Of course it's a small error, but mentioning here, maybe it's not the latest code?

https://github.com/zelogik/RicinoNext/blob/main/Software/Emitter/irda_robi/Emitter.ino#L120
`idMask = 0x80 // 128; // 0b10000000`
Line missing the ";"

Peck07, 2022-02-10:
attinyX4, didn't really change anything, just uploaded the needed files to jlcpcb :)

zelogik, 2022-02-10:
@Peck07 attinyx4 or attinyx5 don't have the same pinout at all !!! even the code is different PORTA != PORTB for pin 5 or 6

zelogik, 2022-02-10:
.... or maybe i mixing memory ... almost one year without touching that part :-/
You have really re-triggered my need to "finish" this project, or at less have a working product!

zelogik, 2022-02-10:
The attiny85 was my first version, after that got many 4 or 5 hardware version (to get the smallest possible design)
And so the uC shortage was here...
And the attinyX4 was the default (and less expensive), and working here without any troubles now, and with some hair pulling, I was able to fit everything (crc, random ID generator, parity generator, and even one heartbeat LED, reset function) , on 1704bytes !! We even can add something more :-D
And now the attiny24 is my default hardware

zelogik, 2022-02-10:
@Peck, the last thing, i don't remember if it's attiny or attinycore ... i just know that one have bug with micros(), so effectively, filling wiki could be useful :-D

Peck07, 2022-02-10:
Ok, I'm getting confused :D
I've tried to compile with attiny, but I've remembered I've read somewhere attinycore... in the Readme:
"ATTinyCore no bootloader
first designed for attiny85, should work even on attiny25 (1394bytes of flash and 17bytes compiled)
disable millis/micros()"

I've tried with ATTinyCore, but got compile errors:
```
error: '_delay_us' was not declared in this scope
             _delay_us(PERIOD_WAIT_START);
```

Plus if I disable the suggested milli/micros:
```
error: 'micros' was not declared in this scope
     static uint32_t timerSend = micros();
```
:)

zelogik, 2022-02-11:
So it must be Attiny, as this code was the one that run on my 30 transponders.
Don't forgive that I have done so much hardware/bootloader/firmware modification to get it works, and so the readme is maybe a little outdated ;-D
The only bug know is the random Generator, seem like it don't exploit the 24bits, but only 10 or 16bits, just need to increase the loop, without doing buffer overflow :-D

ie: you can change _delay_us(PERIOD_WAIT_BIT); with delayMicroseconds(PERIOD_WAIT_START); i you have time to see if attinycore works too.

attiny -> 1690bytes
attinyCore -> 1636bytes

Peck07, 2022-02-16:
@zelogik just seend the edits: soo, what is the final conclusion? :)
use attinycore, or attiny?

zelogik, 2022-02-16:
Be able to use both :-D, but i haven't found solution yet to get information at compile time, to detect if it's Attiny or AttinyCore.

And to be honest haven't got time to test emitter code/hardware, more focused on the controller and receiver part.

Should we continu on discussions and/or mail ?

Peck07, 2022-02-18:
@zelogik yes, mail would be better :)

zelogik, 2022-02-18:
Add Gmail to my Nickname, i will respond with my true email 😁

Closed 2022-02-10.

Thread 27 (2022-02-14):

Missing RX/TX shunt on the receiver ...

zelogik, 2022-02-14:
@Peck07,as it, the receiver will no work (even after soldering/uploading uC), my bad, you need to solder the shunt on the controller side.  that rely the TX(328p)/RX(atmega16) and RX(328p)/TX(atmega16).
I have seen that yesterday when tested the receiver.

Will post a photo when home.

Todo: update the hardware PCB do don't have to solder this shunt.

And on the others side, should have 3 solder/jumper, for setting gate number, need to finish/test the algo:
- everything unshorted/unsoldered -> set the gate i2c address to the one set in the code/firmware
- give us maximum 7 receiver/gates :)

Peck07, 2022-02-15:
No problem, these are easily solveable problems :)
Also, the order could be debugged, if I receive my boards.

Thread 30 (2022-02-16):

Add: Solo mode, in backend and frontend

zelogik, 2022-02-16:
A really nice feature could be to add solo mode, that mean only show 1 player lap

so:
- On the backend side, should be easy to implement, just need to avoid every sort, buffer etc..., only send JSON as received (almost)
- On the frontend side, need to change the <div class="col-md-10" id="stats">, as already said, i'm not an JS expert, just the {live} that can change a little bit

@Peck07 : what to you thing? do you thing is easily

Peck07, 2022-02-18:
I don't exactly understand what would be the difference? :)
You can use it with 1 player right now I think.

zelogik, 2022-02-18:
How i see the solo mode is: the backend filtering the first detected ID, and send only that one (feature already implemented on the backend). And on the front-end, instead of resetting at each lap the line, add a new line at each lap. (And coloring best lap, best checkpoint, etc...)

zelogik, 2022-02-22:
@Peck07 : are you here ? :-D
Need some help to implement solo mode on the frontend side

zelogik, 2022-02-27:
No problem, I was really busy too. For the moment the style/column could be the same, but later could be better to remove name/id/currentTime for example to got more space for others time.

The last merge almost working, just create a new line at each checkpoint (and not at each full lap), and the line order was not as expected (I think last time should be on top)

Peck07, 2022-03-02:
@zelogik ok, just read again your last message above.
I'll check the line order, but I don't know how we can tell if it was a full lap.

zelogik, 2022-03-03:
@Peck07 i was thinking about that too, maybe need to check the "race: {lap}" with the "live"
Or maybe check if the last live:{lap} is different from the new live:{lap} received message if different, mean, it's a new lap.

Or add on the backend a boolean to said live:{newlap=true}, when new lap.
Or add on the backend an uint_8 saying the checkpoint number, and so, comparing with the number of gates.

Peck07, 2022-03-03:
reversed the order, and stopping the stopwatches: https://github.com/zelogik/RicinoNext/commit/a87a5a1a7a4971f892e99b13b707034e17b1abd3

zelogik, 2022-03-26:
@Peck07 : the solo mode seem to "work" but now need to adapt line color, seem to display N+1 line (ie: display 11Lines for 10 laps), total time is "strange"

So many improvement and debug to be done on the backend and frontend. unfortunately, my free time is very low now, job/grade changing since 3weeks :-D
My mail: zelogik.spam  { at } gmail, and I will respond with my official mail.

Thread 33 (2022-03-23):

Emitter PCB - weak/insufficient breakway tabs

QuadCorei8085, 2022-03-23:
Hi,

Thanks for the awesome work. I just tried to order the emitter (after successfully trying out your code on an arduino uno) however JLCPCB rejected the manufacturing with the info: "Please kindly add more breakway tabs between the pcbs for more stable .thanks."

I believe they are missing some structural holding pieces on top and bottom:
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

Could you please be so kind and upload a gerber that has support on both sides?

zelogik, 2022-03-26:
Hi @QuadCorei8085,

I don't want to be too harsh in response, but I will try to make it clear :-D
1) I was able to order that exact design at JLCPCB, without problems. strange message from JLCPCB..., maybe try another time, hoping the "checker" will pass the design, or ask for "capacities/guidances"

2) As i have enough board at home, I can pass some time to upload new/changed design but without get any reviews from me as I don't have fund to purchase others boards to get final result, and check if the new design is ok :-/

3) I can upload the non-panelized version, but with SMD soldering, need to increase size, etc... (and same problem as "2)" )

4)  That project is completely open-source, so feel free to adapt, pull request are kindly welcomed :-D

5) To be honest, I don't have many free time for the next week(month), and I don't want to pass much time to add breakway tab.(because it's a pain in the a?s for me, as I'm not a PCB designer :-/, but it's an really easy problem to debug for new user :-D )

6) Just some help if you want to modify it: don't change the X-Y size, neither the board(s) coordinate as the SMD placement need to be updated too if changed. And neither the global size for cost "problem".
Need to change like that:

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

Hope my responses wasn't too brutal :)

QuadCorei8085, 2022-03-29:
Thanks for the answer, i 100% understand your points and status.

I made my own schematic based on yours and hopefully it will work (reassigned some pins for easier routing and removed the watchdog led).

Do you have the project still? Did you use EasyEDA maybe? Then I could also just panelize it myself. SMD is no problem i would order it with assembly mounting too.  I'm also no pcb designer so i would prefer to work with the already proven design rather than ordering my drawing and having to figure out what i missed :)

zelogik, 2022-03-29:
@QuadCorei8085 . dont know if it's enough for you:
https://easyeda.com/join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

Next step will be to add in OSHWlab.

QuadCorei8085, 2022-03-29:
Thanks this is exactly what i needed. If you want to share the design with others via github: the easyeda always makes a proejct copy in the workspace directory (assuming you use the desktop client) and 2 json files describe the sch and the pcb.

Closed 2022-03-29.

Thread 34 (2022-09-11):

does it work with 3.3V?

isopix, 2022-09-11:
Hi,

Does it work with 3.3V? (it's what Siku Racing cars provides and it's enough for original Robitronic [unlike EZLap/EasyLap and other clones])

Don't have link now, it was on german forum (I've got only translated parts of it):
> "Very important!!! absolutely use the original transponders from robitronic!! The bangood and co have additionally installed a blue LED, which ensures that the voltage probably goes down too far. the 3.7v from the battery is just enough for the robitronic transponder to work."

zelogik, 2022-09-11:
Hello,

'Should' works... The attiny24 datasheet say the operating voltage is 2.7-5.5v for the attiny84-20mu for 8mhz. In the same time, the attiny84**v** version is able to go down to 1.8v at 4mhz, so need to change hard coded timing code.

Regards

isopix, 2022-09-11:
That's superb.

But does anybody sells this emmiters? (not everybody have skills to make PCB themselves and I guess it would be cheaper in bulk anyway)
While I recently bought two robitronic sets(USB+serial) it's hard to get additional transmitters at all. So compatible, but cheaper would be a hit for many ;-)

From description I guess it's not only lap counting hw, but that this software aims to replace soft like FlipSideRacing, NextLevelTiming, or Zround, but it's in very early state and unusable for end-users(that owns Robitronic already ;-) While there's theoretically OSS FlipSideRacing for linux, it's source code only, that's dependand RealBasic, which is not longer distributed and needs proper license. So it would be also gamechanger for linux ;-)

cheers

zelogik, 2022-09-12:
The only thing that could be problematic it's the IR led voltage. I don't know if the led don't send IR at all or the distance is reduced.
For the OS compatibility, it's OS independant, as it's works on uC (Arduino stack)

The only downside, it's that i doesn't have time anymore to de it for the moment.
And no, nobody sell it for the moment. Sort of Royalty comming to the project could motivate me and give some time to dev :-)

BlaineEhrhart, 2022-09-12:
@isopix Next Level Timing will not be easily replaced 😉

While I have not open sourced Next Level Timing, I have started to work on an open source race protocol called [Neon Timing](https://github.com/NextLevelTiming/neon-timing-protocol). Cue xkcd standards comic. The objective of this protocol is to enable different types of race devices to communicate with each other. It is still under development.

@zelogik - maybe you would be interested in using a protocol like this. Here is an [example implementation](https://github.com/NextLevelTiming/neon-timing-serial-example) using a ESP32 and serial communication. This is a simple lights project but I want to build a decoder project as well. I soldered up a ESP32 and IR sensor last weekend just haven't had time to solder up a transmitter and write some test code.

Closed 2022-09-11.

Thread 36 (2023-01-11):

Start signal lights support

isopix, 2023-01-11:
Do you plan adding support for start signal lights(like LEDs connected to Arduino)?

I bought needed parts to make them, but the only software that supports them are proprietiary and very pricey (or doesnt support both USB/rs232 Robitronics)

zelogik, 2023-01-24:
If you look at the README.md:

> - Light/Relay -> Port + light intensity ( + delay off / warm up phase/ etc..)
> - RGB Light -> Port + color

So, almost everything is there (software API/infrastructure) just need time to continue this project.

Thread 39 (2024-07-17):

module protocol todo

zelogik, 2024-07-17:
Change i2c protocol with cheap rs485 board and protocol

Problems: i2c is not adapted for long wire distance

Thread 40 (2024-08-13):

Infrared transmitter not responding

my187119, 2024-08-13:
I followed your schematic and successfully programmed the board. I used my original master control test (Robitronic), but there was no response. I used a logic analyzer to analyze the waveform (as shown in the figure). What is the reason?
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

zelogik, 2024-08-29:
Hi,

I try to understand your problem, as I see receiver board (with USB) AND two emitter (real robitronic/cheap clone/modified PCB from this repo/?), is the problem is the emitter or receiver ? ( confirm that it's the receiver..., even if you show code for emitter...)

What I see is that the receiver board blink when there is a emitter in front (pic2).
Please describe a little more your problem please :D

Thanks

my187119, 2024-09-04:
This time I redesigned the PCB according to your schematic, but it still doesn't respond. Can you take a complete usage video on YouTube, or send it to my gmail: my1871192876@gmail.com, thank you
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

zelogik, 2024-09-05:
How to send a video, If i don't exactly know your problem?!?

Could you please describe precisely your problem, what you have done etc...?
But what i see is that you completely redesign PCB (emitter and receiver), so error could be here, and you don't push, release your PCB design...
I don't know if you have flashed both uC, don't know if you want use with Master or USB after etc...

my187119, 2024-09-05:
Could you provide me your contact information? Communication here is too slow.
