zelogik/RicinoNext/Hardware/Receiver/irda_robi/PCB files/Schematic_IRDA_I2C_2021-09-16.pdf

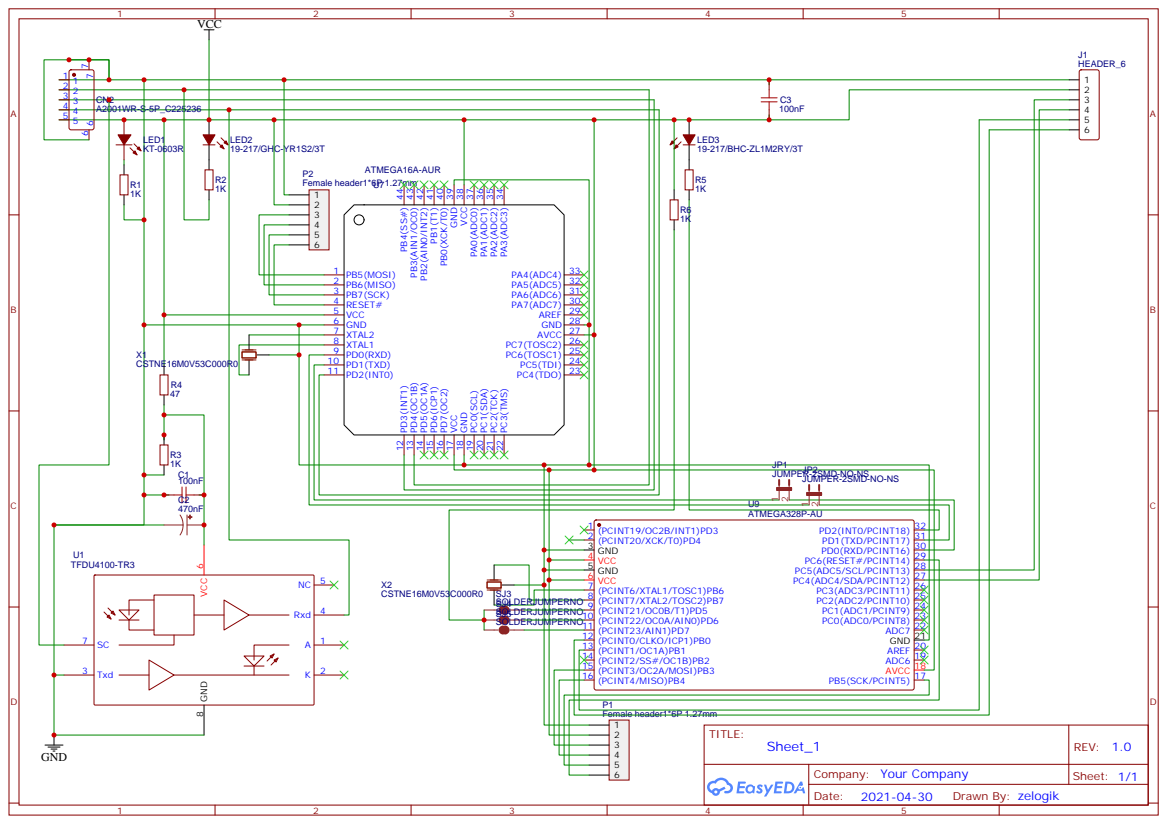
[picture p6: page 1]

ATMEGA16A-AUR
PC4(TDO) 23 PC5(TDI) 24 PC6(TOSC1) 25 PC7(TOSC2) 26 AVCC 27 GND 28 AREF 29 PA7(ADC7) 30 PA6(ADC6) 31 PA5(ADC5) 32 PA4(ADC4) 33 PA3⁽ADC3⁾ 34 PA2⁽ADC2⁾ 35 PA1⁽ADC1⁾ 36 PA0⁽ADC0⁾ 37 VCC 38 GND ³⁹ PB0⁽XCK/T0⁾ 40 PB1⁽T1⁾ 41 PB2⁽AIN⁰/INT2⁾ 42 PB3⁽AIN¹/OC0⁾ 43 PB4⁽SS#⁾ ⁴⁴
