zelogik/RicinoNext/Hardware/Receiver/irda_robi_extension/PCB files/Schematic_IRDA_DumbReceiver_2021-09-16.pdf

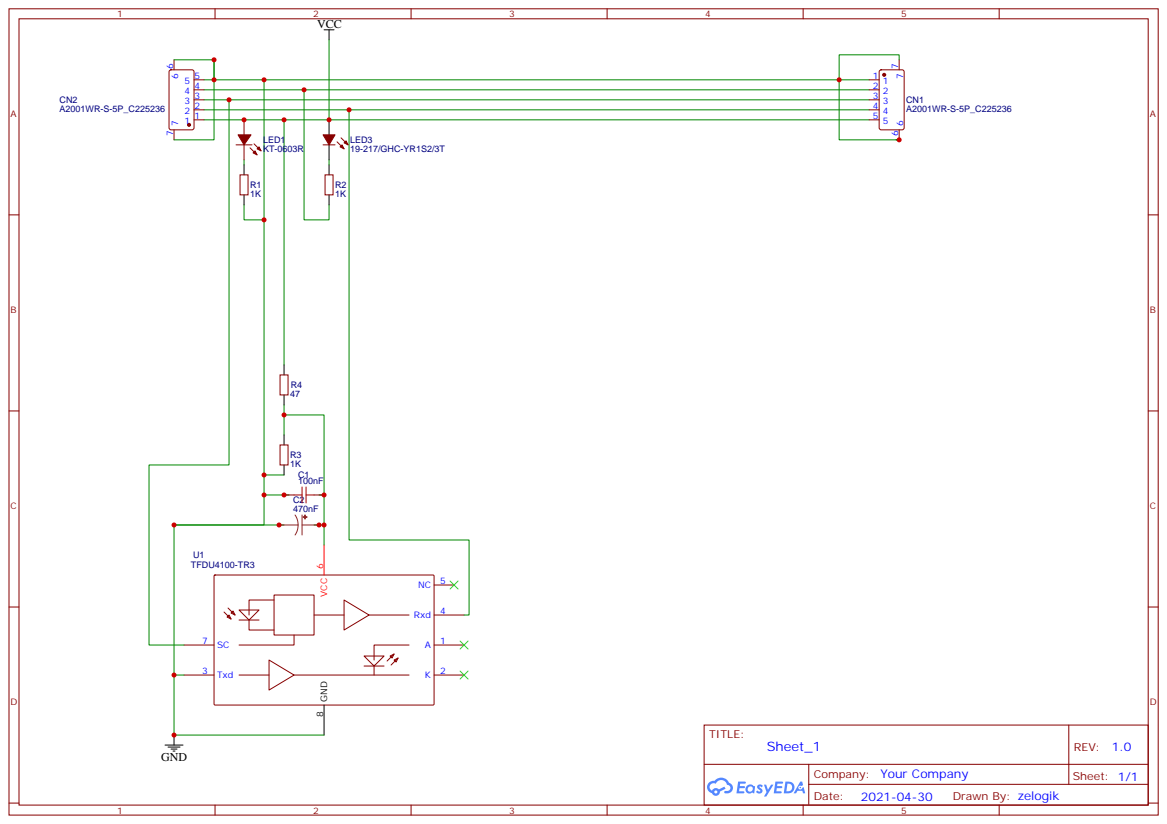
[picture p7: page 1]
