zelogik/RicinoNext/Hardware/Emitter/irda_robi/Schematics/Schematic_IRDA_Emitter_X4_2021-09-15.pdf

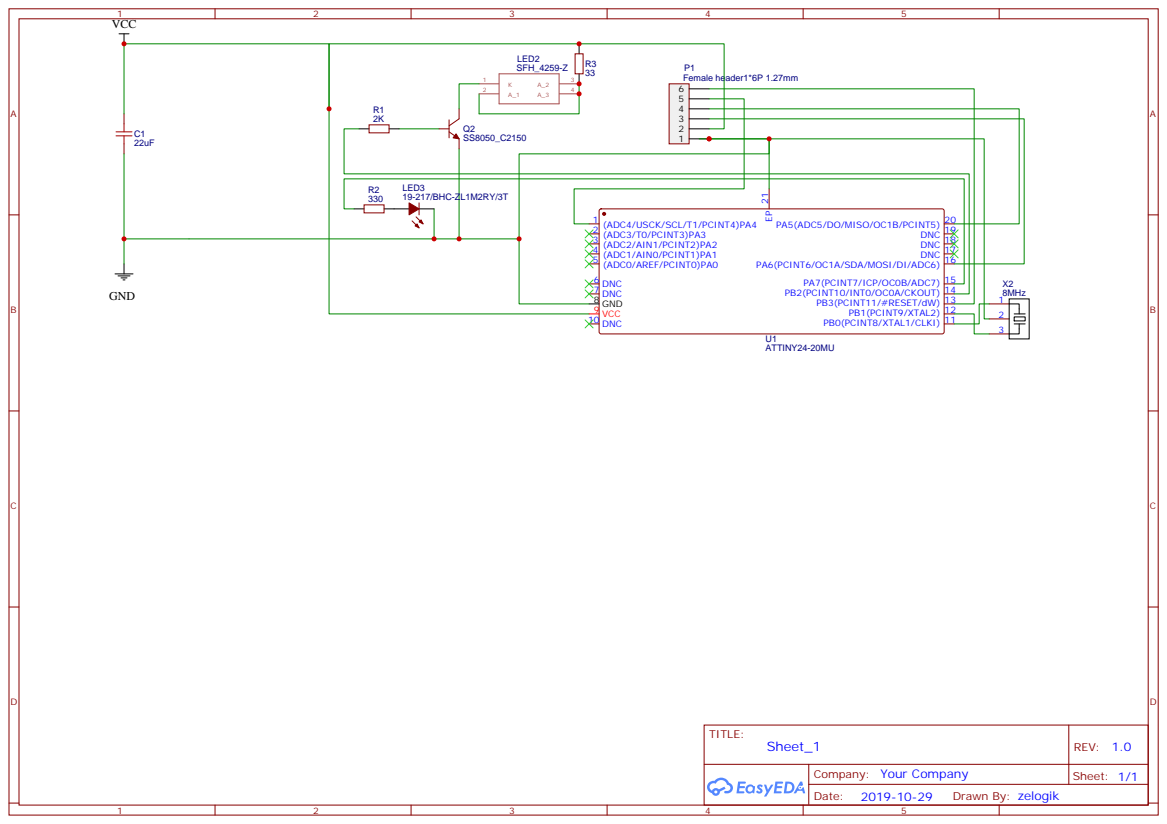
[picture p8: page 1]
