zelogik/RicinoNext/(commit log)

2021-09-15 Add files via upload
    Add Schematics
2021-09-15 Add files via upload
    Update bom,pick&place,Gerber.
    Have been done with easyEDA, altium or kicad should works.
    [BOM_PCB_IR smd attiny_simple panelize_2021-09-15.csv, PickAndPlace_PCB_IR smd attiny_simple panelize_2021-09-15.csv]
2021-09-16 Add files via upload
    Big upload!, now need to comment/explain/make some wiki :)
    [BOM_PCB_IRDA_2021-09-16.csv, BOM_PCB_lapcounter_receiver_2021-09-16.csv, PickAndPlace_PCB_IRDA_2021-09-16.csv, PickAndPlace_PCB_lapcounter_receiver_2021-09-16.csv]
2022-01-25 check devel branch for old debug code
    [BOM_PCB_IR smd attiny_simple panelize_2021-09-15.csv, BOM_PCB_IRDA_2021-09-16.csv, BOM_PCB_lapcounter_receiver_2021-09-16.csv, PickAndPlace_PCB_IR smd attiny_simple panelize_2021-09-15.csv, PickAndPlace_PCB_IRDA_2021-09-16.csv, PickAndPlace_PCB_lapcounter_receiver_2021-09-16.csv]
2022-01-25 Missing code
    [BOM_PCB_IR smd attiny_simple panelize_2021-09-15.csv, BOM_PCB_IRDA_2021-09-16.csv, BOM_PCB_lapcounter_receiver_2021-09-16.csv, PickAndPlace_PCB_IR smd attiny_simple panelize_2021-09-15.csv, PickAndPlace_PCB_IRDA_2021-09-16.csv, PickAndPlace_PCB_lapcounter_receiver_2021-09-16.csv]
2022-01-30 Add: Debug version of the controller (Draft)
    First debug version!
    to do:
    - Add JSON output (need to implement a nicer way than the way it's already writen) (only one function/class and not send JSon everywhere on the software!)
    - Add I2C connection ( just a pseudo merge, all algo is already done and more or less tested!
2022-02-01 Update RicinoNext-controller.ino
    many things merged. miss i2c communication, add/modify a nice "conf" JSON algorithm.
2022-02-03 Update RicinoNext-controller.ino
    Remove all Button2 call for the moment
2022-02-03 ESP32 compatibility, Button2 comp. switch
2022-02-03 frontend: generate/remove lines dynamically, css simplified
    put back some older, but working functions for button clicks
    StopWatch improved
2022-02-04 Small fixes, comments, line deletion
    [RicinoNext-controller.ino]
2022-02-05 Put back current column
2022-02-05 {race:{message:..}} have been corrected
    [RicinoNext-controller.ino]
2022-02-05 Many fix, add reset, fill id, ..
    [RicinoNext-controller.ino, scripts.js]
2022-02-05 stopWatches refactored / fixed
    [scripts.js]
2022-02-05 added clearing lines (Reset)
    [scripts.js]
2022-02-05 Fix color, reset, init at Start, remove need of Serial
    [RicinoNext-controller.ino, scripts.js]
2022-02-06 Just temp debug fix for confToJSON
    [RicinoNext-controller.ino]
2022-02-06 Fix: Minor typo, space correction etc..
    [RicinoNext-controller.ino]
2022-02-06 Add: welcome message, clean, typo fix
    [RicinoNext-controller.ino]
2022-02-06 Fix: add Light, {race:}, ..
    [RicinoNext-controller.ino, scripts.js]
2022-02-06 Fix: bad optimization uint16_t
    [RicinoNext-controller.ino]
2022-02-07 Fix: (unin8_t)Light, remove light_brightness, typo
    [RicinoNext-controller.ino, scripts.js]
2022-02-07 Todo: Start spring for old scripts.js functions
2022-02-08 Fix: many.., fakeIDtrigger, *numberTotalLaps, raceState
    [RicinoNext-controller.ino]
2022-02-08 PreRelease? Fix: Reset, frontend cosmetic, add: Color Random
    [RicinoNext-controller.ino, scripts.js]
2022-02-09 Add: I2C code integration, not in use..
2022-02-10 Fix: ESP8266 compilation, add somes comments/todos
    [RicinoNext-controller.ino]
2022-02-10 Fix: change on/serveStatic, clean server_init()
    [RicinoNext-controller.ino]
2022-02-10 Clean: space, brackets, etc..
2022-02-11 possible missing define added for ATtinyX5
    [Emitter.ino]
2022-02-11 fix LED blinking "outofbounds" issue
    [Emitter.ino]
2022-02-11 get rid of ATtinyX5, X4 code inside functions (replaced by defines)
    [Emitter.ino]
2022-02-11 Fix: heartbeat timing value
    [Emitter.ino]
2022-02-11 Fix: remove that nasty ">=" code optimisation
    [Emitter.ino]
2022-02-12 Fix: Strange behavior with Wire interrupt..
    [RicinoNext-controller.ino, RicinoNext-receiver.ino]
2022-02-12 Add: pseudo working i2c connection
2022-02-12 Feature: First 'should' working I2C communication
2022-02-13 Add: Pre-release i2c comm with fakeID, not bug-free
    [RicinoNext-controller.ino, RicinoNext-receiver.ino]
2022-02-13 RELEASE: Fix: Should work with I2C hardware, almost bug-free
    [RicinoNext-controller.ino, RicinoNext-receiver.ino]
2022-02-13 Bug: why don't output data anymore..
    [RicinoNext-controller.ino]
2022-02-14 Fix: Remove solo mode.. one thing at a time
    [RicinoNext-controller.ino]
2022-02-14 time check, update, fix
    [RicinoNext-controller.ino]
2022-02-15 Frontend: Some fix, mode time/laps
    [RicinoNext-controller.ino, scripts.js]
2022-02-15 Fix/Bug, looking for no init/reset
    [RicinoNext-controller.ino, RicinoNext-receiver.ino]
2022-02-16 Add many debug Serial.print...
2022-02-16 clean: Only cleaning, fix typo, add/del comments
    [RicinoNext-controller.ino]
2022-02-16 Delete: millis to char template, as it use 64bits.
2022-02-16 fix bad commit, reset
    [RicinoNext-controller.ino]
2022-02-17 Fix: solo/style test and fix
    [RicinoNext-controller.ino]
2022-02-17 Fix lap/time frontend, change nullptr JSONToConf
    [RicinoNext-controller.ino, scripts.js]
2022-02-17 Fix: make backend solo work, frontend typo
    [RicinoNext-controller.ino, scripts.js]
2022-03-03 solo mode: fix gate/lap issue
    [scripts.js]
2022-03-08 Fix: Compile and blinking led
    - Add defined to fix compilation error when choosing attiny (and not attinycore), so should be compatible with both now
    - Fix blinking led algo
    [Emitter.ino]
2022-03-08 Fix: compile attinyCore
    Change by macro at start ?
    [Emitter.ino]
2026-10-17 v2: contrôleur Python/MicroPython (ESP32) + récepteur RS485
    q
    quit
    - controller/ : même code sur PC (simulateur) et ESP32 (MicroPython, modules .mpy),
    interface web (course, résultats, records, garage, réglages, système/OTA),
    bus RS485 ou I2C, règles de comptage (anti-rebond, ordre des portes, tolérance)
    - receiver/ : firmware unique des portes (ATmega328PB) en RS485, tests de mise au point,
    dump du décodeur ATmega16
    - documentation : README et INSTALL
2026-10-17 Update README with new version information
    Added a note about the new version for ESP32 with RS485 and linked to the README for version 2.
2026-10-17 v2: schéma de câblage d'ensemble
2026-10-17 v2: English docs, web interface in English / French (EN/FR button)
